eastdown/Feedback_Loop_QuETI/(commit log)

2026-08-10 Add deployed RF Power Lock final snapshot
2026-09-06 Remove board address and host key from handoff doc
2026-09-06 Remove board address from deploy note
